linuxianer99/ga_fuelstation_terminal_hw/README.md

# GA_FuelStation_Terminal_HW

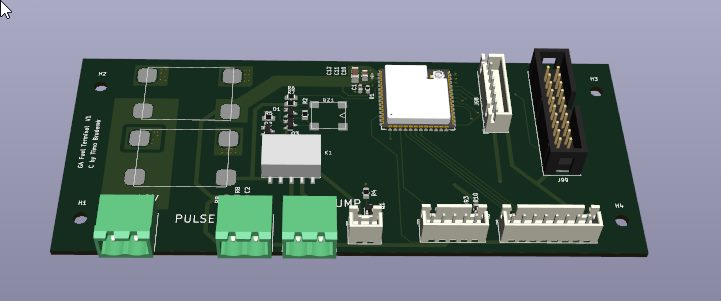
[picture p1: doc/PCB.jpg]
Picture of the PCB PCB


## Name
This is the hardware repository for GA GA_FuelStation_Terminal

## Description
KICAD Project for an RFID Terminal based on ESP32-S3
