linuxianer99/ga_fuelstation_terminal_hw/BOM.ods

Source: | E:\code_temp\GA Fuel Station\GA_FuelStation_Terminal\hardware\GA_Fuelstation_Terminal\GA_Fuelstation_Terminal.kicad_sch
Date: | 18.06.2023 13:51:07
Tool: | Eeschema 7.0.2
Generator: | D:\Program Files\KiCad\7.0\bin\scripting\plugins/bom_csv_grouped_by_value_with_fp.py
Component Count: | 34
Ref | Qnty | Value | Cmp name | Footprint | Description
BZ1 | 1 | Buzzer | Buzzer | GA_Fuelstation_Terminal:8530-SMD | Buzzer, polarized
C1 | 1 | 1u | C | Capacitor_SMD:C_0603_1608Metric_Pad1.08x0.95mm_HandSolder | Unpolarized capacitor
C2 | 1 | 100nF | C | Capacitor_SMD:C_0603_1608Metric_Pad1.08x0.95mm_HandSolder | Unpolarized capacitor
C10 | 1 | 100nF / 50V | C | Capacitor_SMD:C_0402_1005Metric_Pad0.74x0.62mm_HandSolder | Unpolarized capacitor
C11 | 1 | 1uF | C | Capacitor_SMD:C_0805_2012Metric_Pad1.18x1.45mm_HandSolder | Unpolarized capacitor
C12 | 1 | 10uF / 25V | C | Capacitor_SMD:C_1206_3216Metric_Pad1.33x1.80mm_HandSolder | Unpolarized capacitor
D1 | 1 | D | D | Package_TO_SOT_SMD:SOT-23 | Diode
H1, H2, H3, H4 | 4 | MountingHole | MountingHole | MountingHole:MountingHole_3.2mm_M3 | Mounting Hole without connection
IC1 | 1 | ESP32-S3-WROOM-1 | ESP32-S3-WROOM-1 | Espressif:ESP32-S3-WROOM-1U | 2.4 GHz WiFi (802.11 b/g/n) and Bluetooth Â® 5 (LE) module Built around ESP32S3 series of SoCs, Xtensa Â® dualcore 32bit LX7 microprocessor Flash up to 16 MB, PSRAM up to 8 MB 36 GPIOs, rich set of peripherals Onboard PCB antenna
J1 | 1 | Conn_01x08_Pin | Conn_01x08_Pin | Connector_JST:JST_XH_B8B-XH-AM_1x08_P2.50mm_Vertical | Generic connector, single row, 01x08, script generated
J2 | 1 | Conn_01x05_Pin | Conn_01x05_Pin | Connector_JST:JST_XH_B5B-XH-AM_1x05_P2.50mm_Vertical | Generic connector, single row, 01x05, script generated
J5 | 1 | Conn_01x02_Pin | Conn_01x02_Pin | Connector_JST:JST_XH_B2B-XH-AM_1x02_P2.50mm_Vertical | Generic connector, single row, 01x02, script generated
J6, J7, J10 | 3 | Screw_Terminal_01x02 | Screw_Terminal_01x02 | Connector_Phoenix_MSTB:PhoenixContact_MSTBA_2,5_2-G-5,08_1x02_P5.08mm_Horizontal | Generic screw terminal, single row, 01x02, script generated (kicad-library-utils/schlib/autogen/connector/)
J98 | 1 | Conn_01x07_Socket | Conn_01x07_Socket | Connector_JST:JST_XH_B7B-XH-AM_1x07_P2.50mm_Vertical | Generic connector, single row, 01x07, script generated
J99 | 1 | Conn_ARM_JTAG_SWD_20 | Conn_ARM_JTAG_SWD_20 | Connector_IDC:IDC-Header_2x10_P2.54mm_Vertical | Standard IDC20 Pinheader Connector, ARM legacy JTAG and SWD interface
K1 | 1 | ~ | TQ2SA | GA_Fuelstation_Terminal:TQ2SA
Q1, Q2, Q3 | 3 | 2N7002 | 2N7002 | Package_TO_SOT_SMD:SOT-23 | 0.115A Id, 60V Vds, N-Channel MOSFET, SOT-23
R1 | 1 | 10k | R | Resistor_SMD:R_0603_1608Metric_Pad0.98x0.95mm_HandSolder | Resistor
R2 | 1 | 1k | R | Resistor_SMD:R_0805_2012Metric_Pad1.20x1.40mm_HandSolder | Resistor
R4, R5, R6 | 3 | 100 | R | Resistor_SMD:R_0805_2012Metric_Pad1.20x1.40mm_HandSolder | Resistor
R7 | 1 | R | R | Resistor_SMD:R_0805_2012Metric_Pad1.20x1.40mm_HandSolder | Resistor
R8 | 1 | 12k | R | Resistor_SMD:R_0805_2012Metric_Pad1.20x1.40mm_HandSolder | Resistor
R9 | 1 | 50k | R | Resistor_SMD:R_0805_2012Metric_Pad1.20x1.40mm_HandSolder | Resistor
U1 | 1 | 3V3 | DCDC | GA_Fuelstation_Terminal:XLZMYQ
U2 | 1 | 5V | DCDC | GA_Fuelstation_Terminal:XLZMYQ
