linuxianer99/ga_fuelstation_terminal_hw/releases/V1/bom.csv

Designator | Footprint | Quantity | Value | LCSC Part #
BZ1 | 8530-SMD | 1 | Buzzer
C1 | 0603 | 1 | 1u
C10 | 0402 | 1 | 100nF / 50V
C11 | 0805 | 1 | 1uF
C12 | 1206 | 1 | 10uF / 25V
C2 | 0603 | 1 | 100nF
D1 | SOT-23 | 1 | D
H1, H2, H3, H4 | MountingHole_3.2mm_M3 | 4 | MountingHole
IC1 | ESP32-S3-WROOM-1U | 1 | ESP32-S3-WROOM-1
J1 | JST_XH_B8B-XH-AM_1x08_P2.50mm_Vertical | 1 | Conn_01x08_Pin
J10, J6, J7 | PhoenixContact_MSTBA_2,5_2-G-5,08_1x02_P5.08mm_Horizontal | 3 | Screw_Terminal_01x02
J2 | JST_XH_B5B-XH-AM_1x05_P2.50mm_Vertical | 1 | Conn_01x05_Pin
J5 | JST_XH_B2B-XH-AM_1x02_P2.50mm_Vertical | 1 | Conn_01x02_Pin
J98 | JST_XH_B7B-XH-AM_1x07_P2.50mm_Vertical | 1 | Conn_01x07_Socket
J99 | IDC-Header_2x10_P2.54mm_Vertical | 1 | Conn_ARM_JTAG_SWD_20
K1 | TQ2SA | 1 | ~
Q1, Q2, Q3 | SOT-23 | 3 | 2N7002
R1 | 0603 | 1 | 10k
R10, R3 | 0805 | 2 | 0R
R2 | 0805 | 1 | 1k
R4, R5, R6 | 0805 | 3 | 100
R7 | 0805 | 1 | R
R8 | 0805 | 1 | 12k
R9 | 0805 | 1 | 50k
U1 | XLZMYQ | 1 | 3V3
U2 | XLZMYQ | 1 | 5V
