linuxianer99/ga_fuelstation_terminal_hw/3D/WIZ850IO--3DModel-STEP-269445.STEP

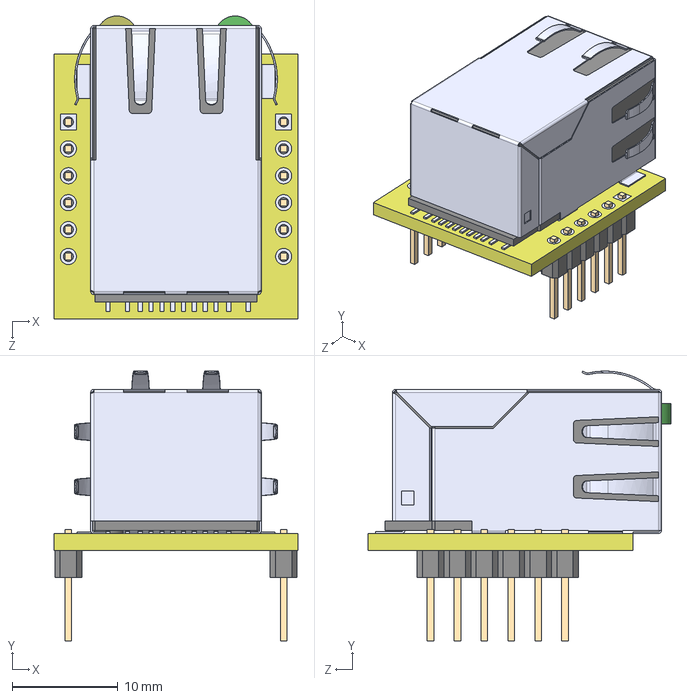
[picture p2: CAD file, 2026-10-18]
3D/WIZ850IO--3DModel-STEP-269445.STEP
23.0 x 25.5 x 28.6 mm
