linuxianer99/ga_fuelstation_terminal_hw/GA_Fuelstation_Terminal.step

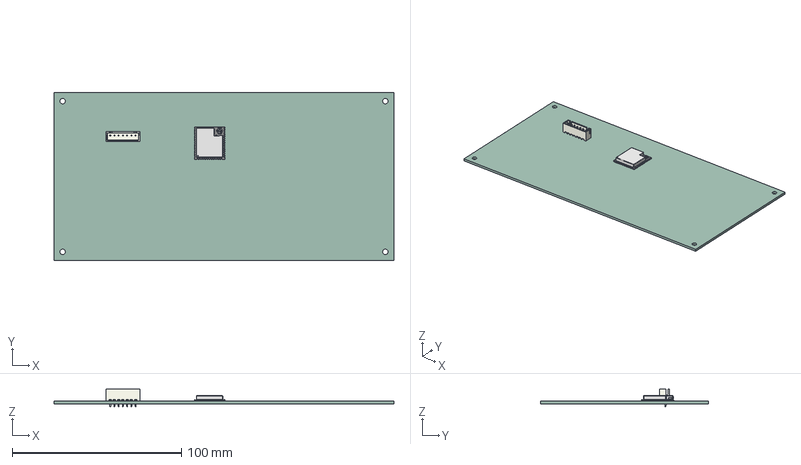
[picture p3: CAD file, 2023-06-21]
GA_Fuelstation_Terminal.step
200.7 x 99.1 x 10.4 mm
GA_Fuelstation_Terminal PCB
