linuxianer99/ga_fuelstation_terminal_hw/GA_Fuelstation_Terminal.pdf

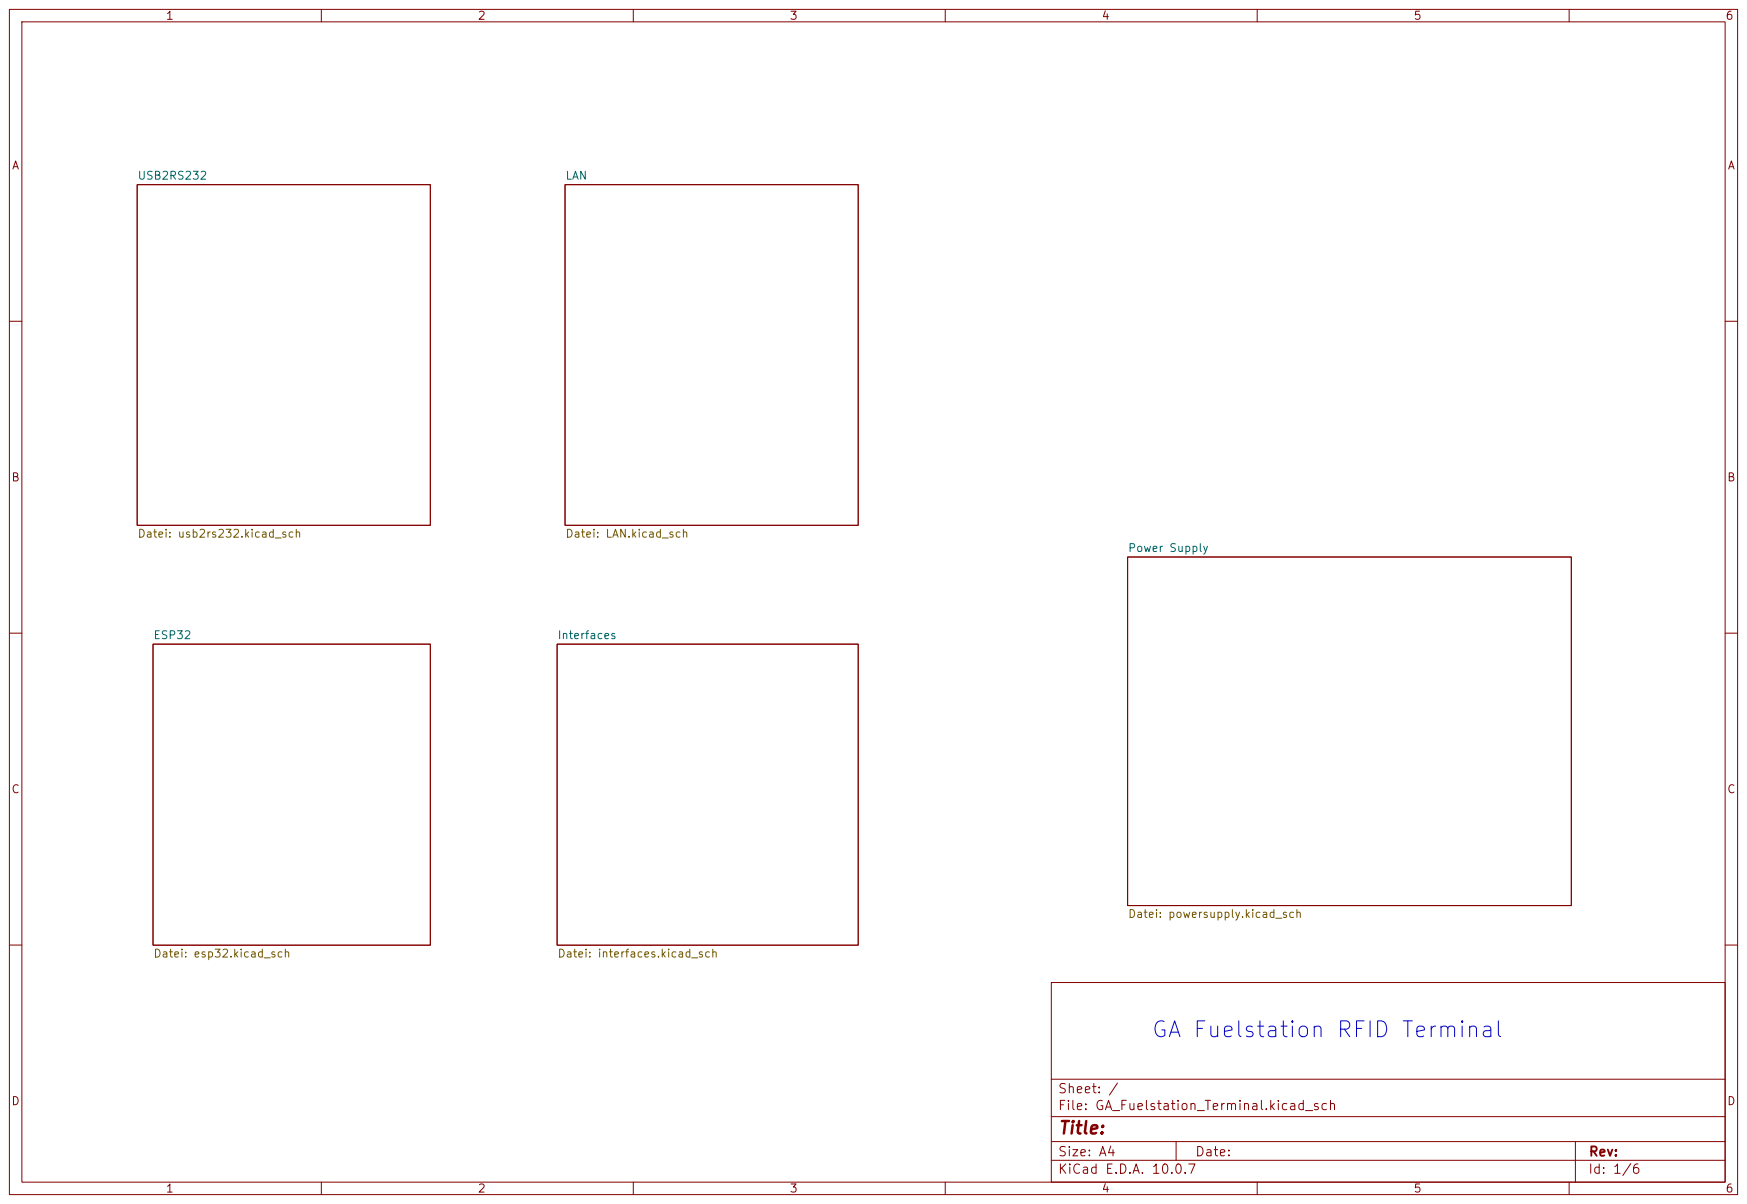
[picture p4: page 1]

Size: A4 | Rev:
KiCad E.D.A. 10.0.7 | Id: 1/6

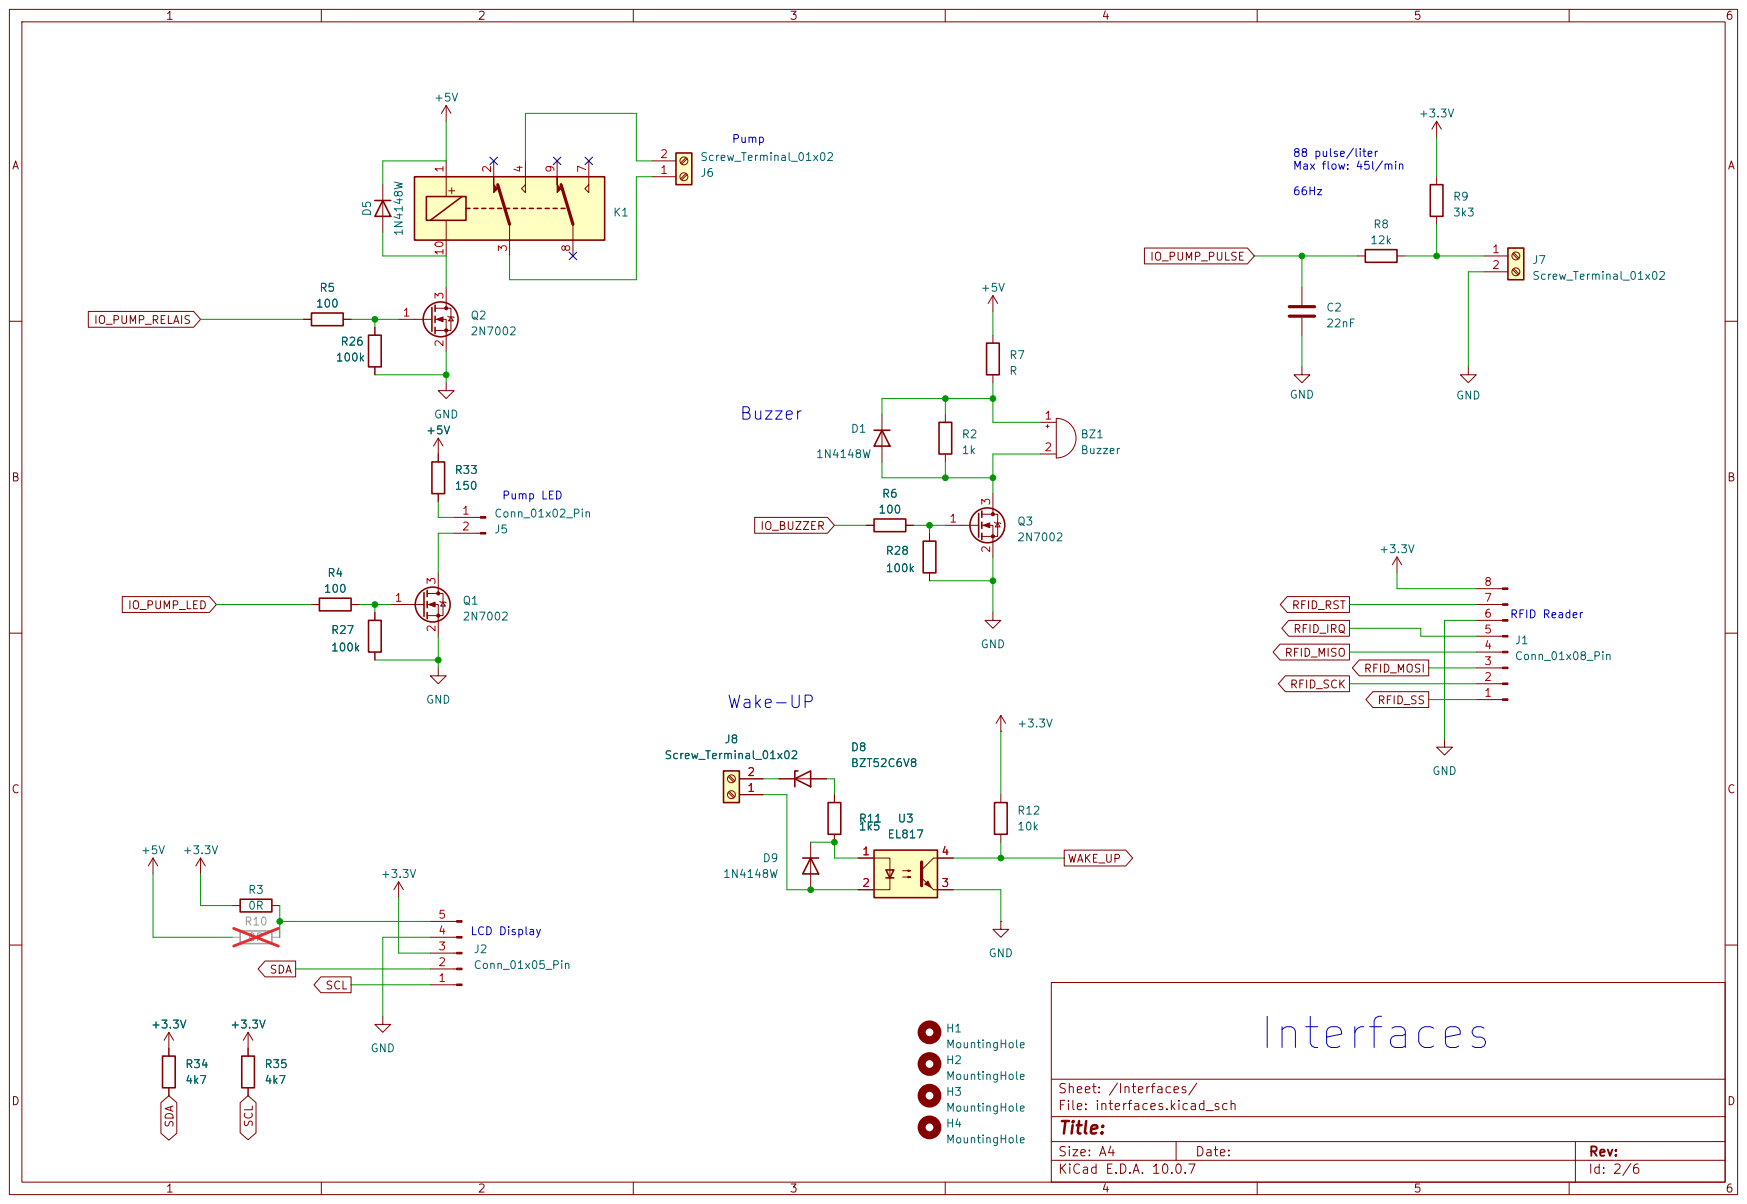
[picture p5: page 2]

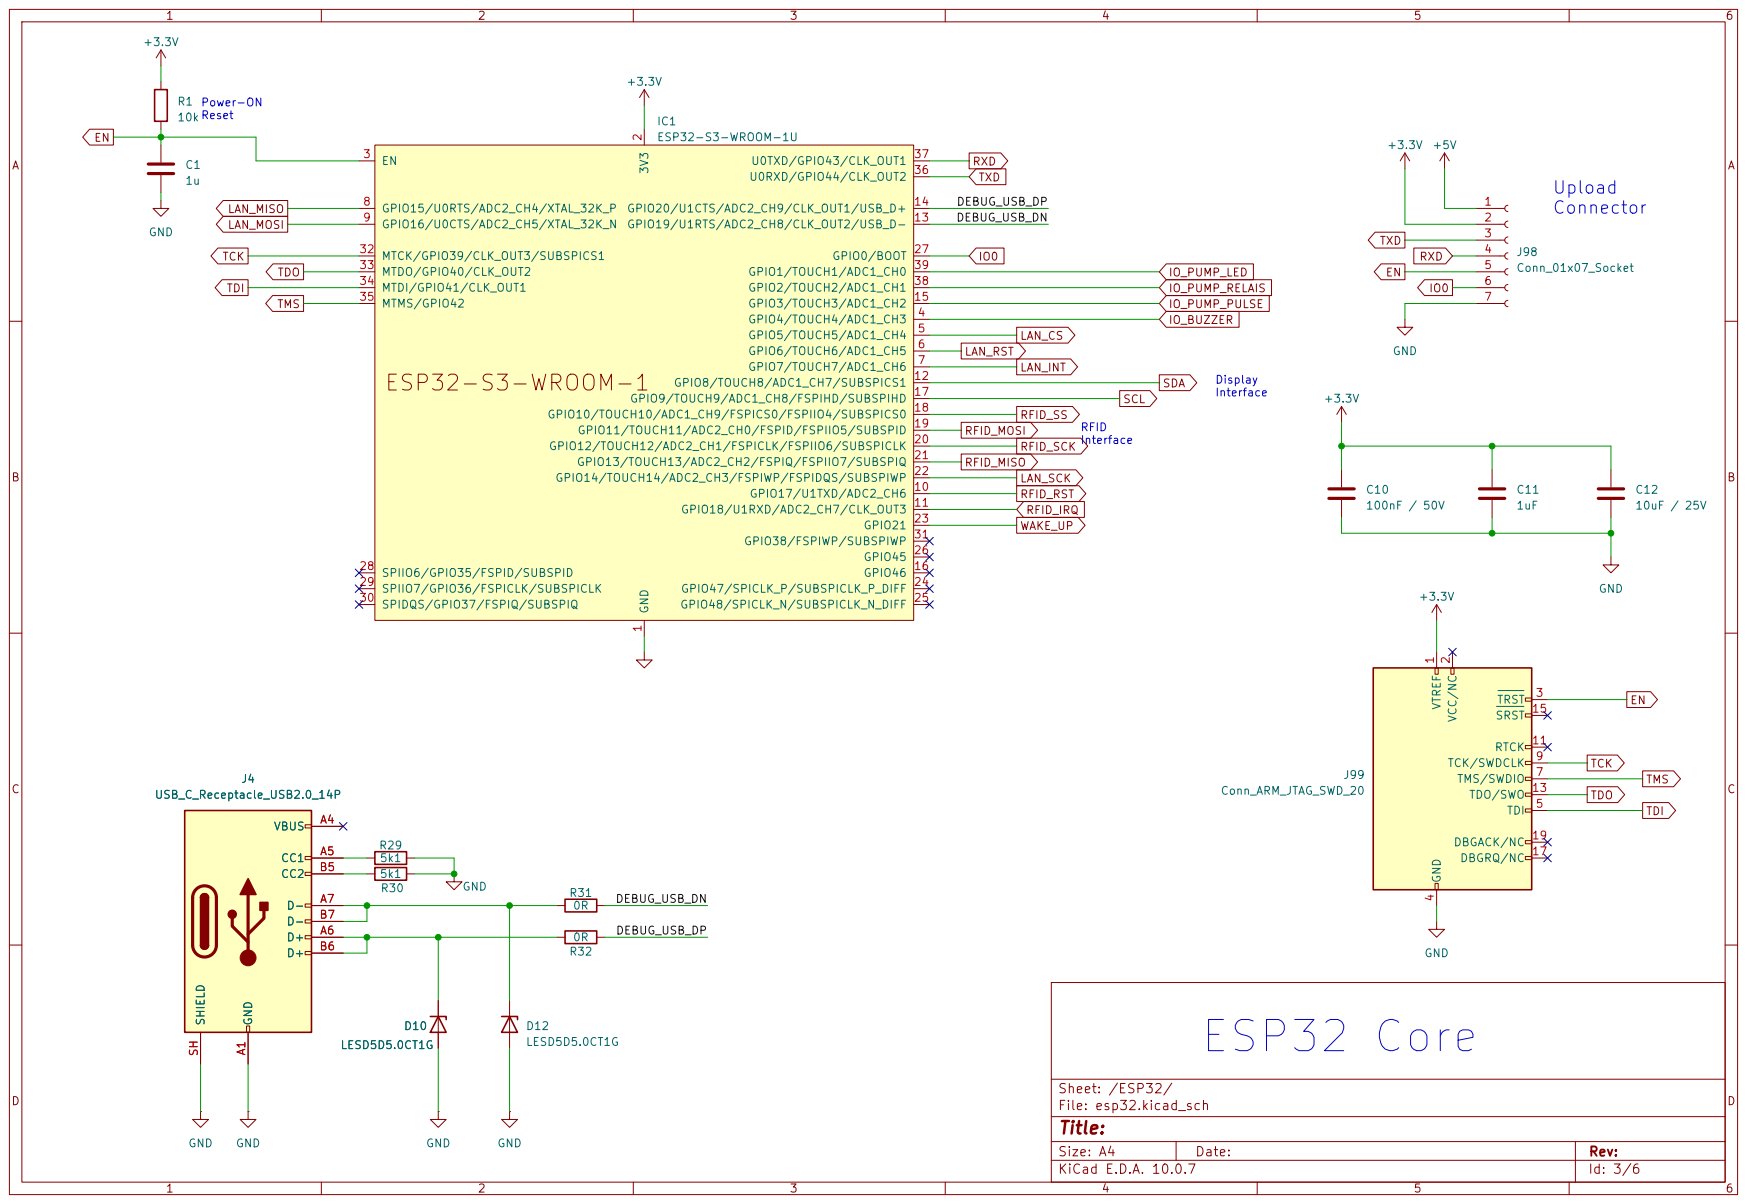
[picture p6: page 3]

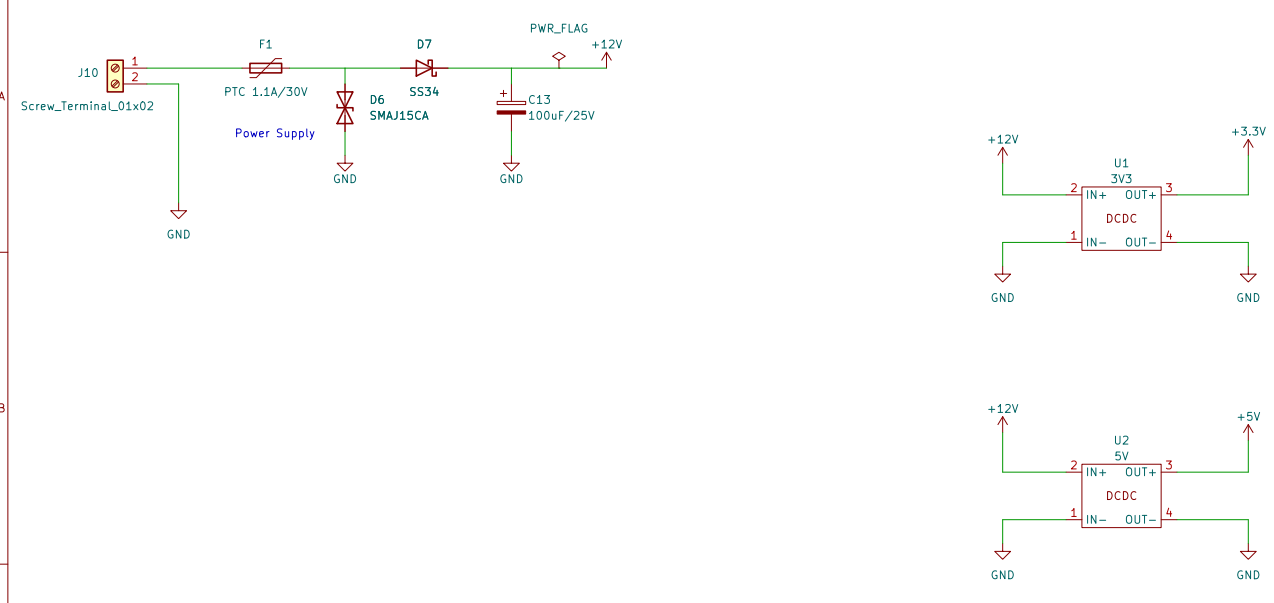
[picture p7: page 4]

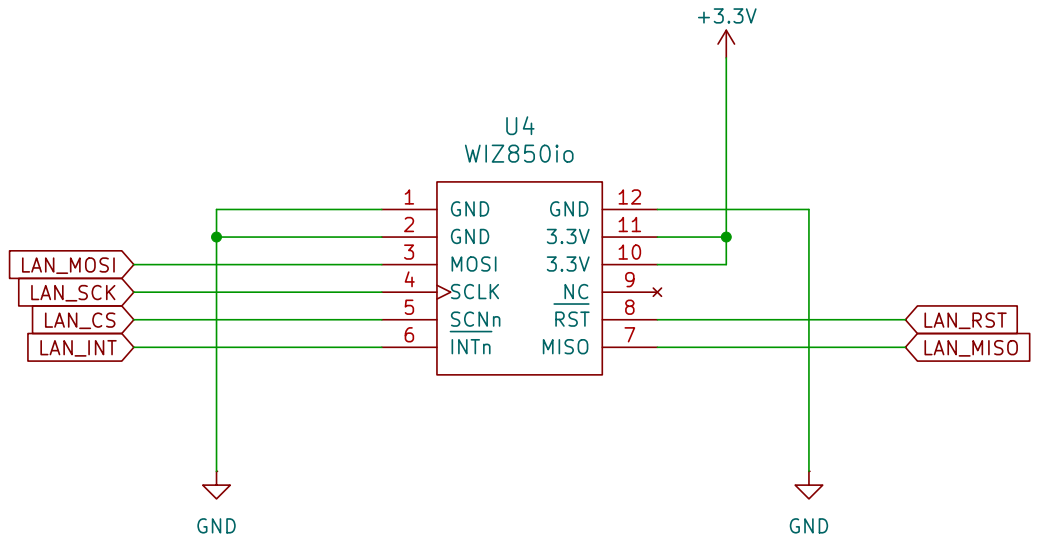
[picture p8: page 5]

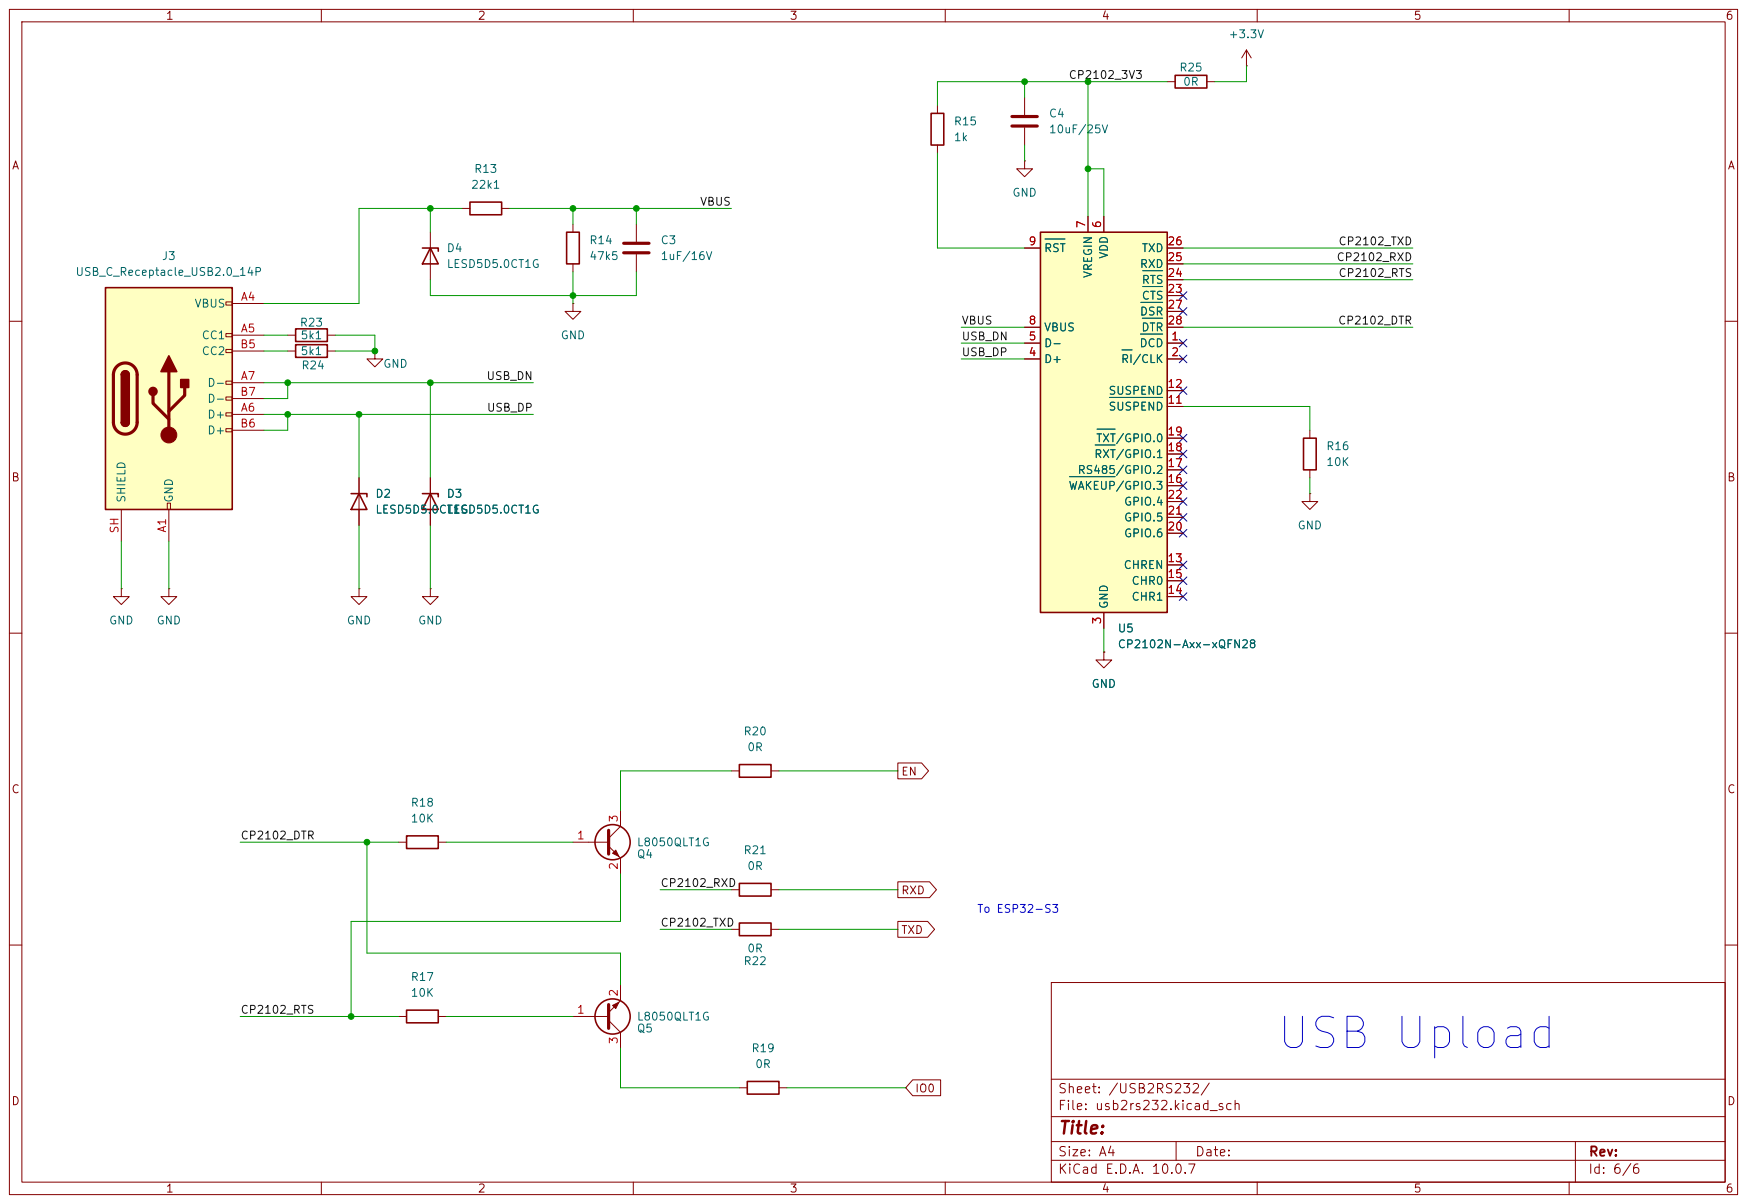
[picture p9: page 6]

SUSPEND 11 SUSPEND 12 CHREN 13 CHR1 14 CHR0 15 WAKEUP/GPIO.3 16 RS485/GPIO.2 17 RXT/GPIO.1 18 TXT/GPIO.0 19 GPIO.6 20 GPIO.5 21 GPIO.4 22 CTS 23 RTS 24 RXD 25 TXD 26 DSR 27 DTR 28

SUSPEND 11 SUSPEND 12 CHREN 13 CHR1 14 CHR0 15 WAKEUP/GPIO.3 16 RS485/GPIO.2 17 RXT/GPIO.1 18 TXT/GPIO.0 19 GPIO.6 20 GPIO.5 21 GPIO.4 22 CTS 23 RTS 24 RXD 25 TXD 26 DSR 27 DTR 28 U5CP2102N-Axx-xQFN28 GND
