linuxianer99/ga_fuelstation_terminal_hw/GA_Fuelstation_Terminal.kicad_pcb

## KiCad design GA_Fuelstation_Terminal.kicad_pcb (2026-11-08)

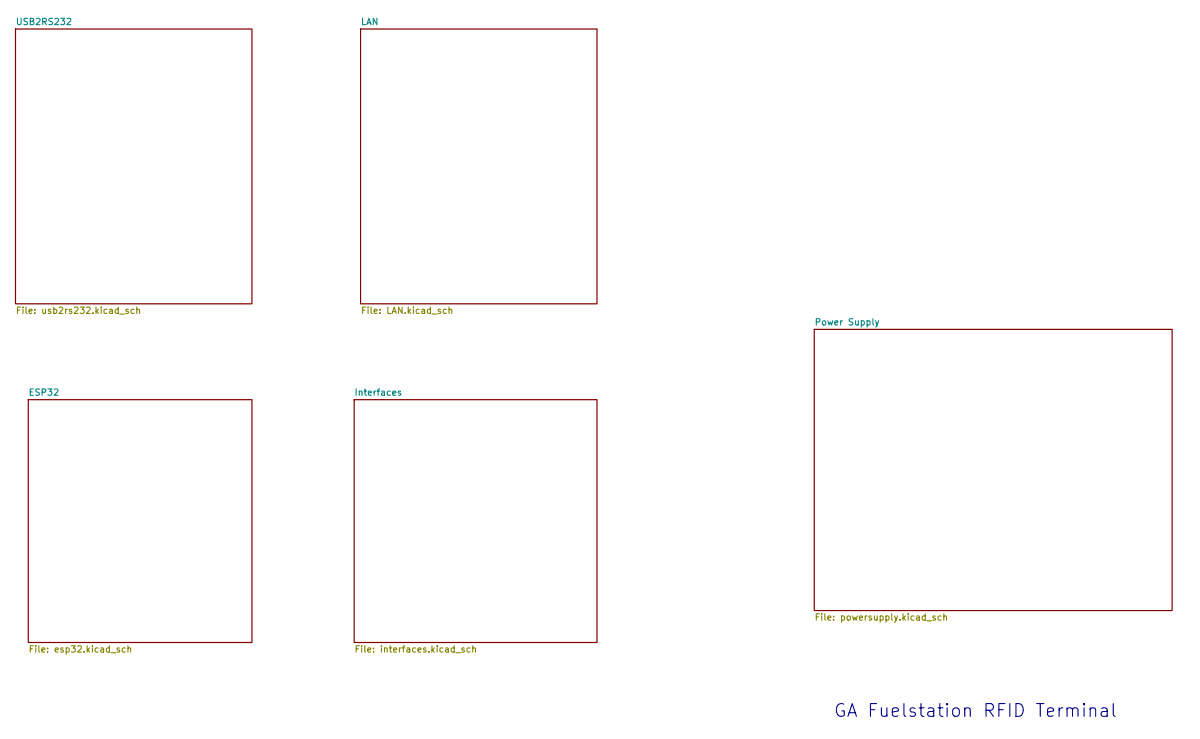
[picture p14: schematic GA_Fuelstation_Terminal.kicad_sch]

Notes on the sheet:
GA Fuelstation RFID Terminal

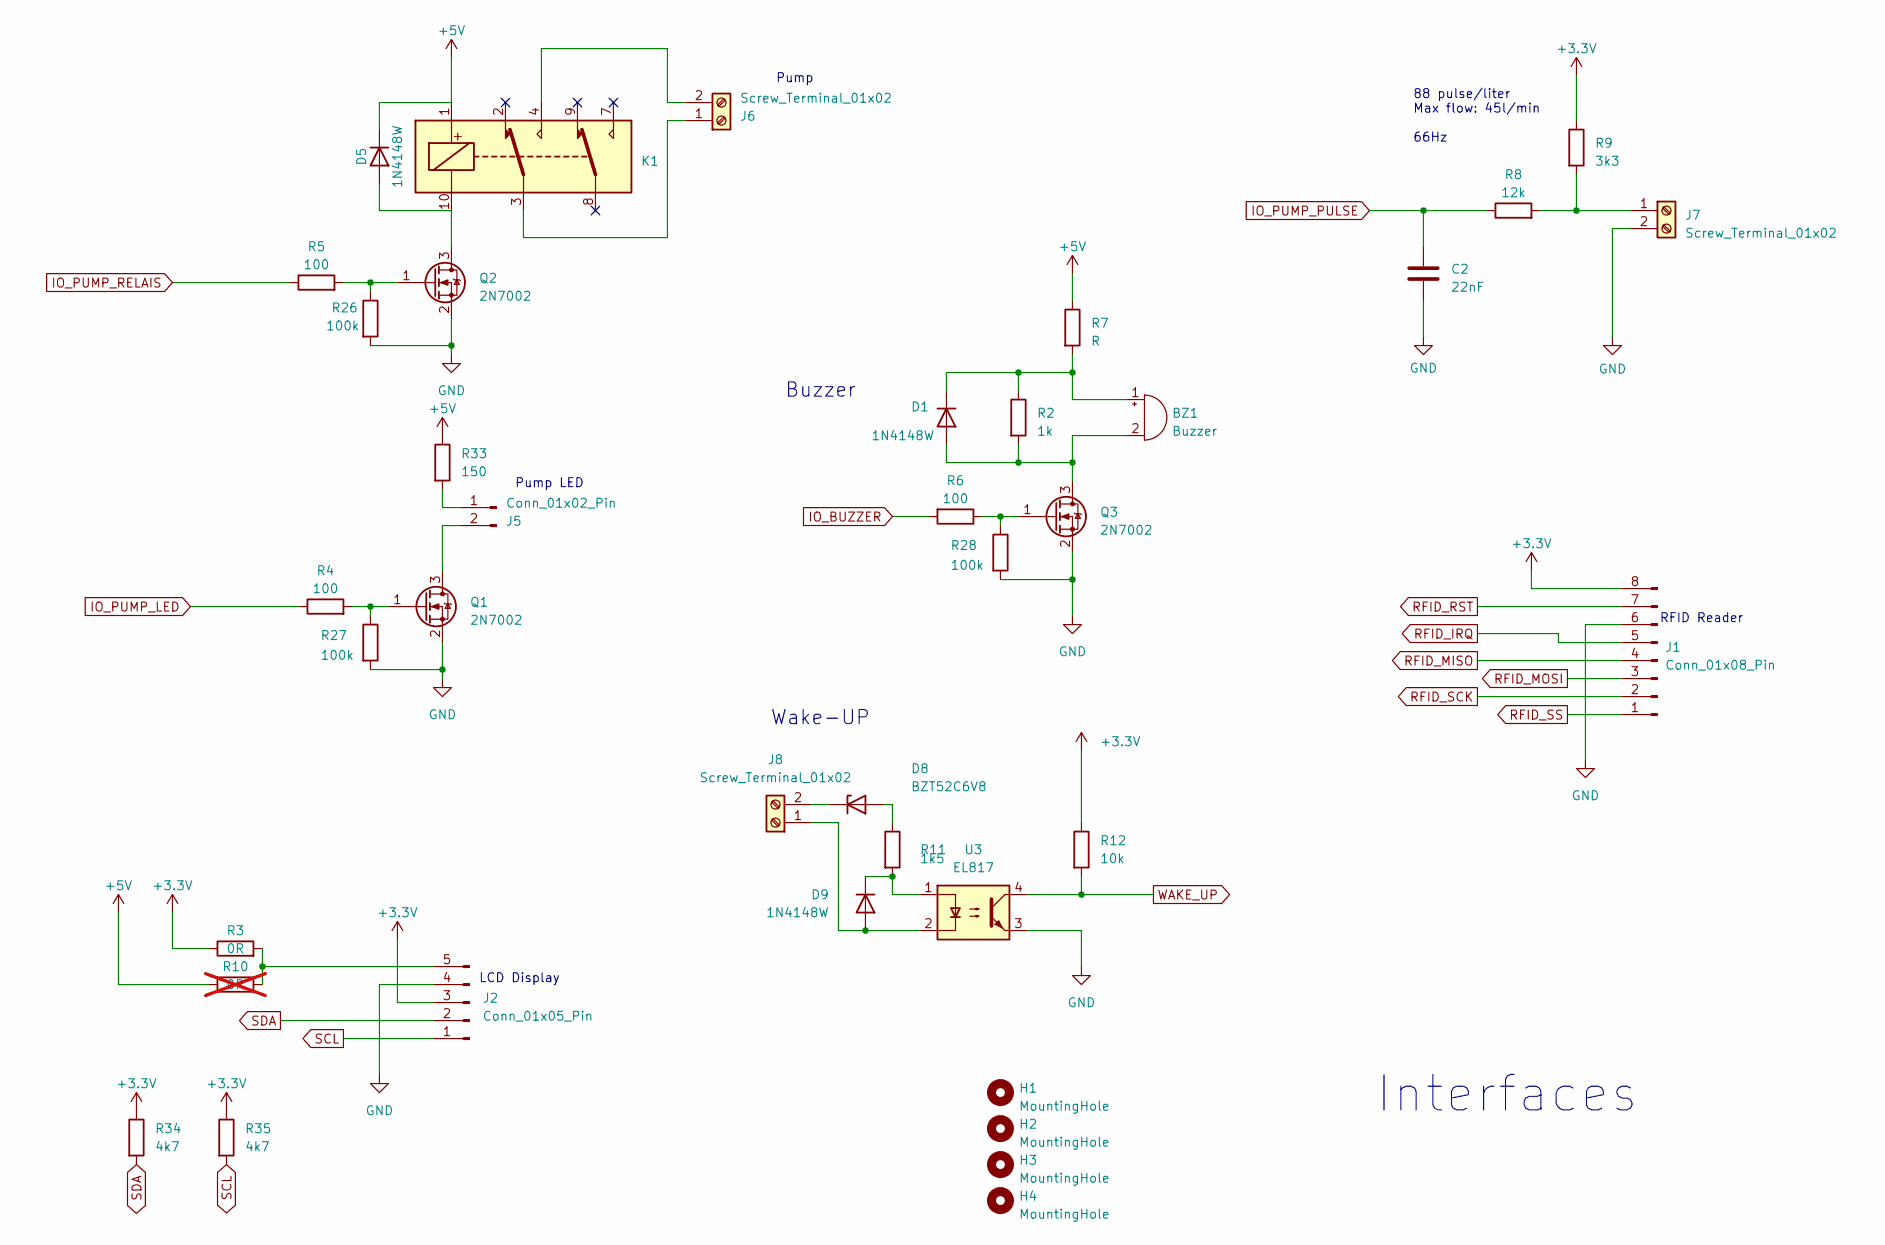
[picture p15: schematic interfaces.kicad_sch]

Parts:
BZ1: Buzzer; 8530-SMD
C2: 22nF; C_0603_1608Metric_Pad1.08x0.95mm_HandSolder
D1, D5, D9: 1N4148W; D_SOD-123; LCSC C81598
D8: BZT52C6V8; D_SOD-123; LCSC C173404
H1, H2, H3, H4: MountingHole; MountingHole_3.2mm_M3
J1: Conn_01x08_Pin; JST_XH_B8B-XH-AM_1x08_P2.50mm_Vertical
J2: Conn_01x05_Pin; JST_XH_B5B-XH-AM_1x05_P2.50mm_Vertical
J5: Conn_01x02_Pin; JST_XH_B2B-XH-AM_1x02_P2.50mm_Vertical
J6, J7, J8: Screw_Terminal_01x02; PhoenixContact_MSTBA_2,5_2-G-5,08_1x02_P5.08mm_Horizontal
K1: TQ2SA
Q1, Q2, Q3: 2N7002; SOT-23
R2: 1k; R_0805_2012Metric_Pad1.20x1.40mm_HandSolder
R3: 0R; R_0805_2012Metric_Pad1.20x1.40mm_HandSolder
R4, R5, R6: 100; R_0805_2012Metric_Pad1.20x1.40mm_HandSolder
R7: R; R_0805_2012Metric_Pad1.20x1.40mm_HandSolder
R8: 12k; R_0805_2012Metric_Pad1.20x1.40mm_HandSolder
R9: 3k3; R_0805_2012Metric_Pad1.20x1.40mm_HandSolder
R10: 0R; R_0805_2012Metric_Pad1.20x1.40mm_HandSolder; not fitted
R11: 1k5; R_0805_2012Metric_Pad1.20x1.40mm_HandSolder; LCSC C4310
R12: 10k; R_0603_1608Metric_Pad0.98x0.95mm_HandSolder
R26, R27, R28: 100k; R_0402_1005Metric_Pad0.72x0.64mm_HandSolder
R33: 150; R_0805_2012Metric_Pad1.20x1.40mm_HandSolder
R34, R35: 4k7; R_0805_2012Metric_Pad1.20x1.40mm_HandSolder
U3: EL817; SMDIP-4_W9.53mm; LCSC C63268

Connections:
+3.3V: J1.8, J2.3, R3.1, R9.1, R12.1, R34.1, R35.1; also elsewhere on the board
+5V: D5.1 (K), K1.1, R7.1, R10.1, R33.1; also elsewhere on the board
GND: C2.2, J1.6, J2.4, J7.2, Q1.2 (S), Q2.2 (S), Q3.2 (S), R26.2, R27.2, R28.2, U3.3; also elsewhere on the board
IO_BUZZER: R6.2; also elsewhere on the board
IO_PUMP_LED: R4.1; also elsewhere on the board
IO_PUMP_PULSE: C2.1, R8.1; also elsewhere on the board
IO_PUMP_RELAIS: R5.1; also elsewhere on the board
unnamed: BZ1.2 (+), D1.2 (A), Q3.3 (D), R2.2
unnamed: BZ1.1 (-), D1.1 (K), R2.1, R7.2
unnamed: D5.2 (A), K1.10, Q2.3 (D)
unnamed: D8.2 (A), R11.1
unnamed: D8.1 (K), J8.2
unnamed: D9.2 (A), J8.1, U3.2
unnamed: D9.1 (K), R11.2, U3.1
unnamed: J2.5, R3.2, R10.2
unnamed: J5.1, R33.2
unnamed: J5.2, Q1.3 (D)
unnamed: J6.1, K1.3
unnamed: J6.2, K1.4
unnamed: J7.1, R8.2, R9.2
unnamed: Q1.1 (G), R4.2, R27.1
unnamed: Q2.1 (G), R5.2, R26.1
unnamed: Q3.1 (G), R6.1, R28.1
RFID_IRQ: J1.5; also elsewhere on the board
RFID_MISO: J1.4; also elsewhere on the board
RFID_MOSI: J1.3; also elsewhere on the board
RFID_RST: J1.7; also elsewhere on the board
RFID_SCK: J1.2; also elsewhere on the board
RFID_SS: J1.1; also elsewhere on the board
SCL: J2.1, R35.2; also elsewhere on the board
SDA: J2.2, R34.2; also elsewhere on the board
WAKE_UP: R12.2, U3.4; also elsewhere on the board

Notes on the sheet:
Buzzer
RFID Reader
Pump
88 pulse/liter Max flow: 45l/min 66Hz
Wake-UP
LCD Display
Pump LED
Interfaces

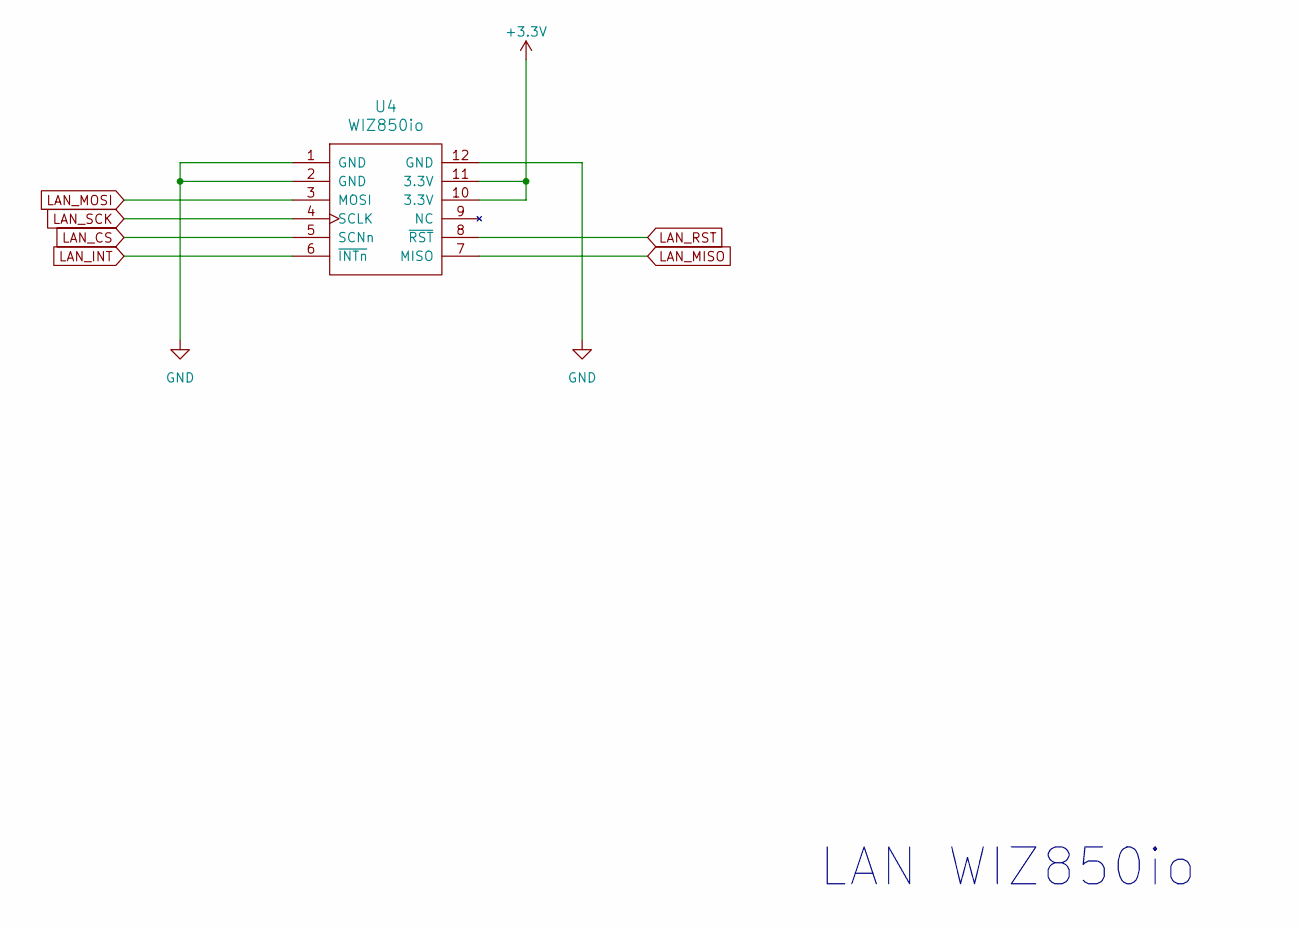
[picture p16: schematic LAN.kicad_sch]

Parts:
U4: WIZ850io

Connections:
+3.3V: U4.10 (3.3V), U4.11 (3.3V); also elsewhere on the board
GND: U4.1 (GND), U4.2 (GND), U4.12 (GND); also elsewhere on the board
LAN_CS: U4.5 (SCNn); also elsewhere on the board
LAN_INT: U4.6 (~INTn); also elsewhere on the board
LAN_MISO: U4.7 (MISO); also elsewhere on the board
LAN_MOSI: U4.3 (MOSI); also elsewhere on the board
LAN_RST: U4.8 (~RST); also elsewhere on the board
LAN_SCK: U4.4 (SCLK); also elsewhere on the board

Notes on the sheet:
LAN WIZ850io

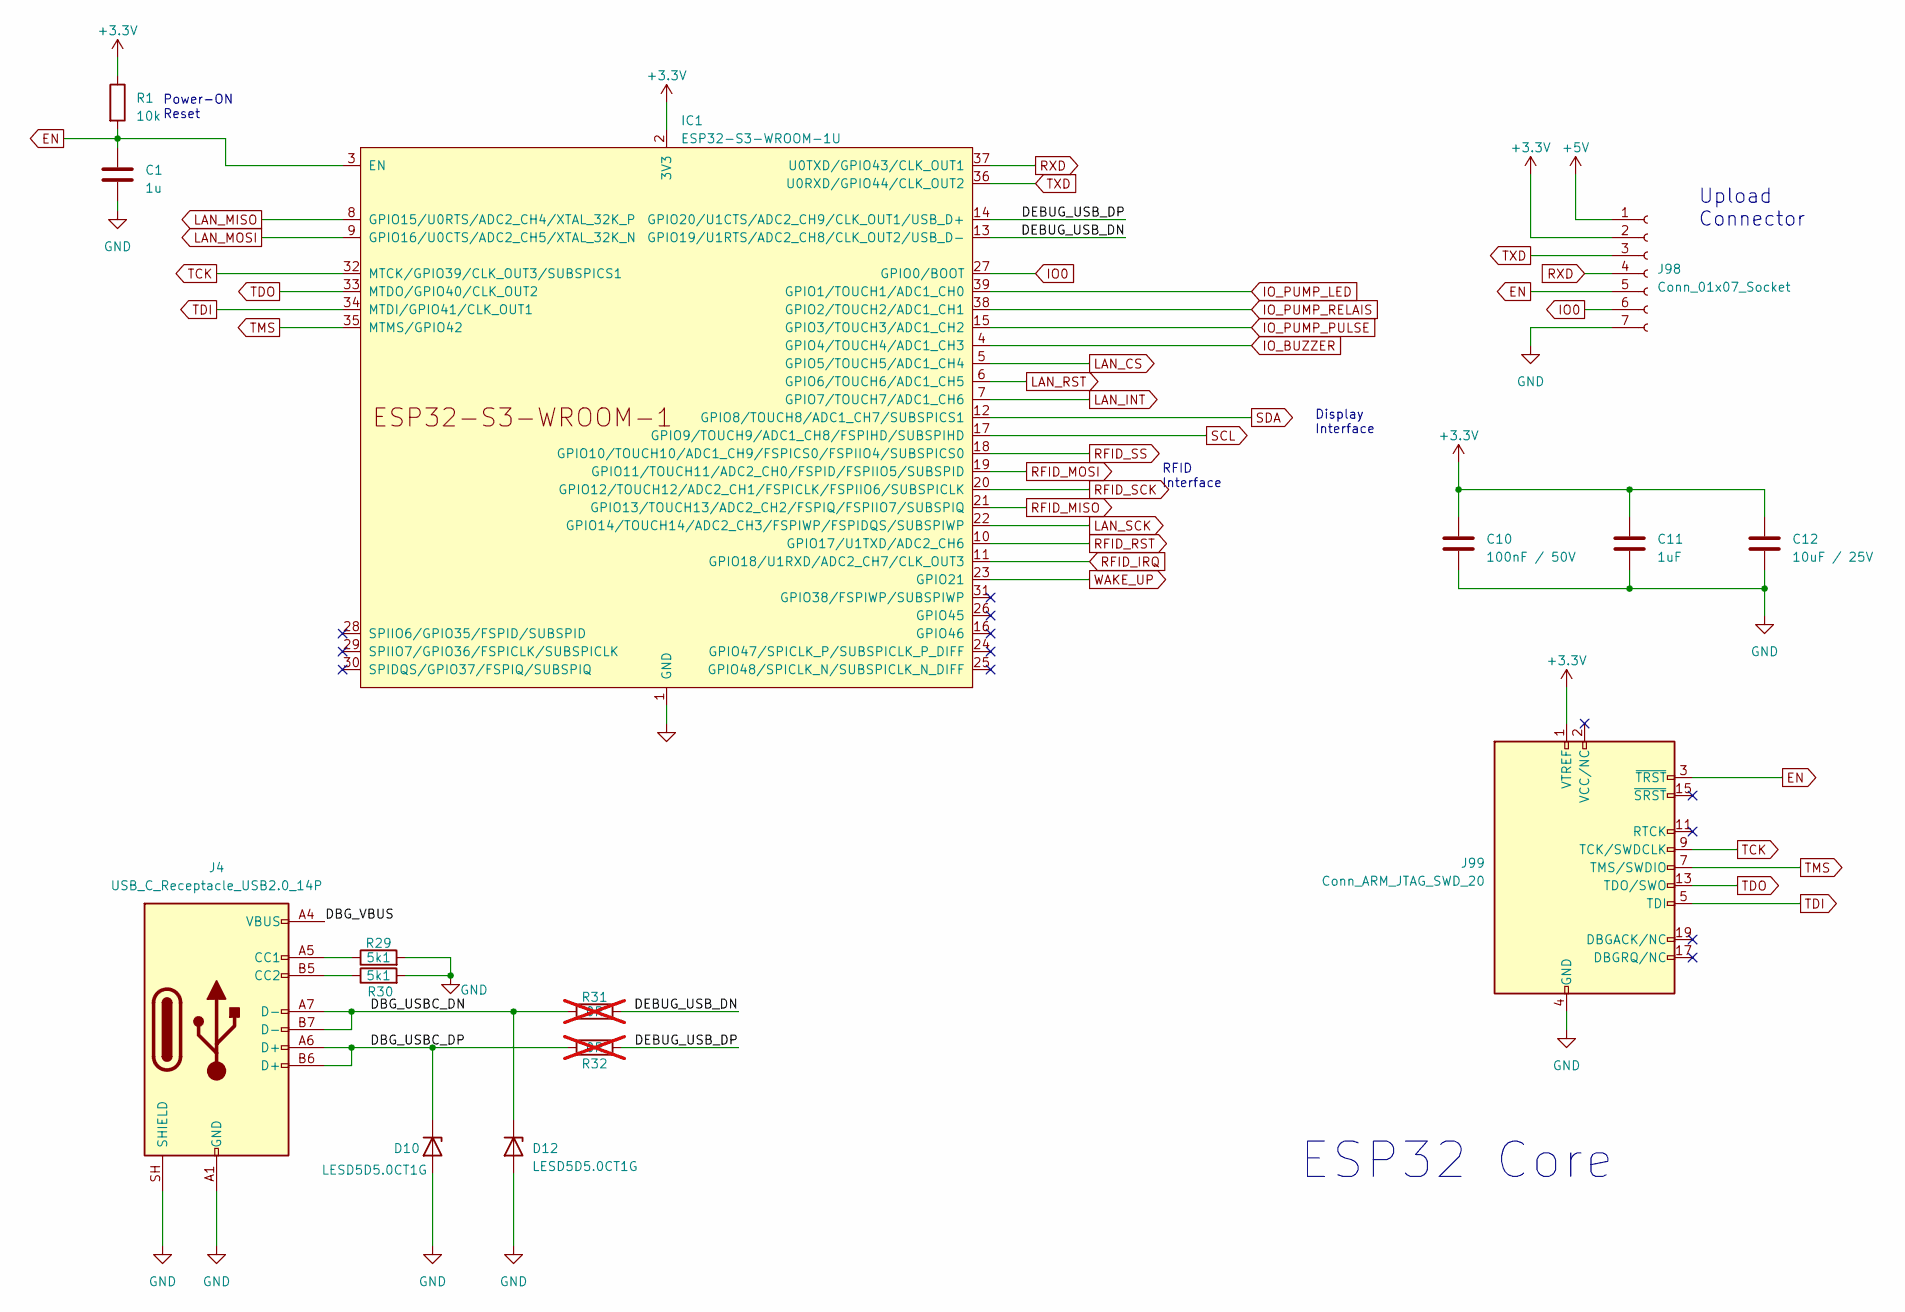
[picture p17: schematic esp32.kicad_sch]

Parts:
C1: 1u; C_0603_1608Metric_Pad1.08x0.95mm_HandSolder
C10: 100nF / 50V; C_0402_1005Metric_Pad0.74x0.62mm_HandSolder
C11: 1uF; C_0805_2012Metric_Pad1.18x1.45mm_HandSolder
C12: 10uF / 25V; C_1206_3216Metric_Pad1.33x1.80mm_HandSolder
D10, D12: LESD5D5.0CT1G; D_SOD-523
IC1: ESP32-S3-WROOM-1U
J4: USB_C_Receptacle_USB2.0_14P; USB_C_Receptacle_HRO_TYPE-C-31-M-12
J98: Conn_01x07_Socket; JST_XH_B7B-XH-AM_1x07_P2.50mm_Vertical
J99: Conn_ARM_JTAG_SWD_20; IDC-Header_2x10_P2.54mm_Vertical
R1: 10k; R_0603_1608Metric_Pad0.98x0.95mm_HandSolder
R29, R30: 5k1; R_0603_1608Metric_Pad0.98x0.95mm_HandSolder
R31, R32: 0R; R_0402_1005Metric; LCSC C17168; not fitted

Connections:
+3.3V: C10.1, C11.1, C12.1, IC1.2 (3V3), J98.2, J99.1 (VTREF), R1.1; also elsewhere on the board
+5V: J98.1; also elsewhere on the board
/ESP32/DBG_USBC_DN: D12.1 (K), J4.A7 (D-), J4.B7 (D-), R31.1
/ESP32/DBG_USBC_DP: D10.1 (K), J4.A6 (D+), J4.B6 (D+), R32.1
/ESP32/DBG_VBUS: J4.A4 (VBUS), J4.A9 (VBUS), J4.B4 (VBUS), J4.B9 (VBUS)
/ESP32/DEBUG_USB_DN: IC1.13 (GPIO19/U1RTS/ADC2_CH8/CLK_OUT2/USB_D-), R31.2
/ESP32/DEBUG_USB_DP: IC1.14 (GPIO20/U1CTS/ADC2_CH9/CLK_OUT1/USB_D+), R32.2
EN: C1.1, IC1.3 (EN), J98.5, J99.3 (~TRST), R1.2; also elsewhere on the board
GND: C1.2, C10.2, C11.2, C12.2, D10.2 (A), D12.2 (A), IC1.1 (GND), IC1.40 (GND), IC1.41 (GND), J4.A1 (GND), J4.A12 (GND), J4.B1 (GND), J4.B12 (GND), J4.SH (SHIELD), J98.7, J99.4 (GND), J99.6 (GND), J99.8 (GND), J99.10 (GND), J99.12 (GND), J99.14 (GND), J99.16 (GND), J99.18 (GND), J99.20 (GND), R29.2, R30.2; also elsewhere on the board
IO0: IC1.27 (GPIO0/BOOT), J98.6; also elsewhere on the board
IO_BUZZER: IC1.4 (GPIO4/TOUCH4/ADC1_CH3); also elsewhere on the board
IO_PUMP_LED: IC1.39 (GPIO1/TOUCH1/ADC1_CH0); also elsewhere on the board
IO_PUMP_PULSE: IC1.15 (GPIO3/TOUCH3/ADC1_CH2); also elsewhere on the board
IO_PUMP_RELAIS: IC1.38 (GPIO2/TOUCH2/ADC1_CH1); also elsewhere on the board
LAN_CS: IC1.5 (GPIO5/TOUCH5/ADC1_CH4); also elsewhere on the board
LAN_INT: IC1.7 (GPIO7/TOUCH7/ADC1_CH6); also elsewhere on the board
LAN_MISO: IC1.8 (GPIO15/U0RTS/ADC2_CH4/XTAL_32K_P); also elsewhere on the board
LAN_MOSI: IC1.9 (GPIO16/U0CTS/ADC2_CH5/XTAL_32K_N); also elsewhere on the board
LAN_RST: IC1.6 (GPIO6/TOUCH6/ADC1_CH5); also elsewhere on the board
LAN_SCK: IC1.22 (GPIO14/TOUCH14/ADC2_CH3/FSPIWP/FSPIDQS/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); also elsewhere on the board
unnamed: J4.A5 (CC1), R29.1
unnamed: J4.B5 (CC2), R30.1
RFID_IRQ: IC1.11 (GPIO18/U1RXD/ADC2_CH7/CLK_OUT3); also elsewhere on the board
RFID_MISO: IC1.21 (GPIO13/TOUCH13/ADC2_CH2/FSPIQ/FSPIIO7/S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); also elsewhere on the board
RFID_MOSI: IC1.19 (GPIO11/TOUCH11/ADC2_CH0/FSPID/FSPIIO5/S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); also elsewhere on the board
RFID_RST: IC1.10 (GPIO17/U1TXD/ADC2_CH6); also elsewhere on the board
RFID_SCK: IC1.20 (GPIO12/TOUCH12/ADC2_CH1/FSPICLK/FSPIIO6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); also elsewhere on the board
RFID_SS: IC1.18 (GPIO10/TOUCH10/ADC1_CH9/FSPICS0/FSPIIO4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); also elsewhere on the board
RXD: IC1.37 (U0TXD/GPIO43/CLK_OUT1), J98.4; also elsewhere on the board
SCL: IC1.17 (GPIO9/TOUCH9/ADC1_CH8/FSPIHD/SUBSPIHD); also elsewhere on the board
SDA: IC1.12 (GPIO8/TOUCH8/ADC1_CH7/SUBSPICS1); also elsewhere on the board
TCK: IC1.32 (MTCK/GPIO39/CLK_OUT3/SUBSPICS1), J99.9 (TCK/SWDCLK)
TDI: IC1.34 (MTDI/GPIO41/CLK_OUT1), J99.5 (TDI)
TDO: IC1.33 (MTDO/GPIO40/CLK_OUT2), J99.13 (TDO/SWO)
TMS: IC1.35 (MTMS/GPIO42), J99.7 (TMS/SWDIO)
TXD: IC1.36 (U0RXD/GPIO44/CLK_OUT2), J98.3; also elsewhere on the board
WAKE_UP: IC1.23 (GPIO21); also elsewhere on the board

Notes on the sheet:
Upload Connector
ESP32 Core
Display Interface
RFID Interface
Power-ON Reset

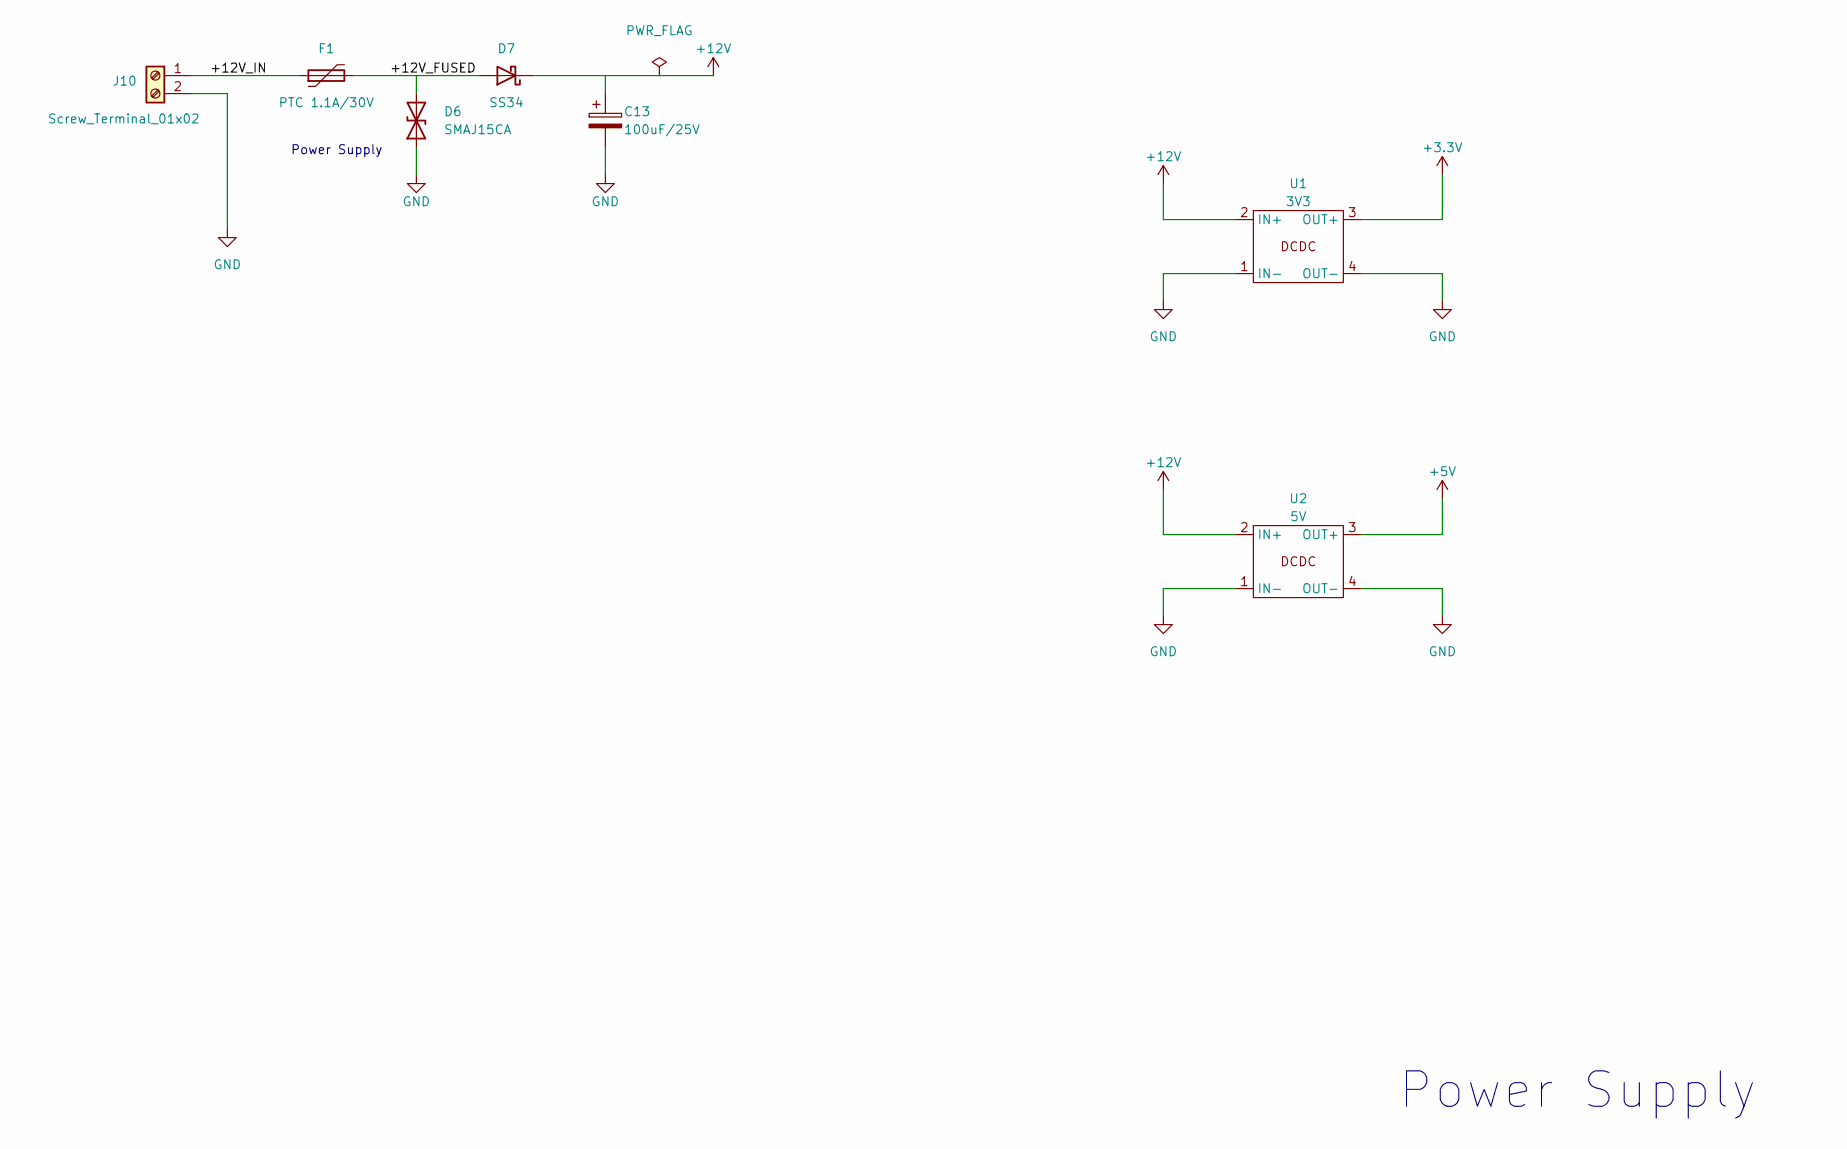
[picture p18: schematic powersupply.kicad_sch]

Parts:
C13: 100uF/25V; CP_Elec_6.3x7.7; LCSC C179802
D6: SMAJ15CA; D_SMA; LCSC C151939
D7: SS34; D_SMA; LCSC C8678
F1: PTC 1.1A/30V; Fuse_1812_4532Metric; LCSC C70119
J10: Screw_Terminal_01x02; PhoenixContact_MSTBA_2,5_2-G-5,08_1x02_P5.08mm_Horizontal
U1: 3V3; XLZMYQ
U2: 5V; XLZMYQ

Connections:
+3.3V: U1.3 (OUT+); also elsewhere on the board
+5V: U2.3 (OUT+); also elsewhere on the board
+12V: C13.1, D7.1 (K), U1.2 (IN+), U2.2 (IN+)
/Power Supply/+12V_FUSED: D6.2 (A2), D7.2 (A), F1.2
/Power Supply/+12V_IN: F1.1, J10.1
GND: C13.2, D6.1 (A1), J10.2, U1.1 (IN-), U1.4 (OUT-), U2.1 (IN-), U2.4 (OUT-); also elsewhere on the board

Notes on the sheet:
Power Supply

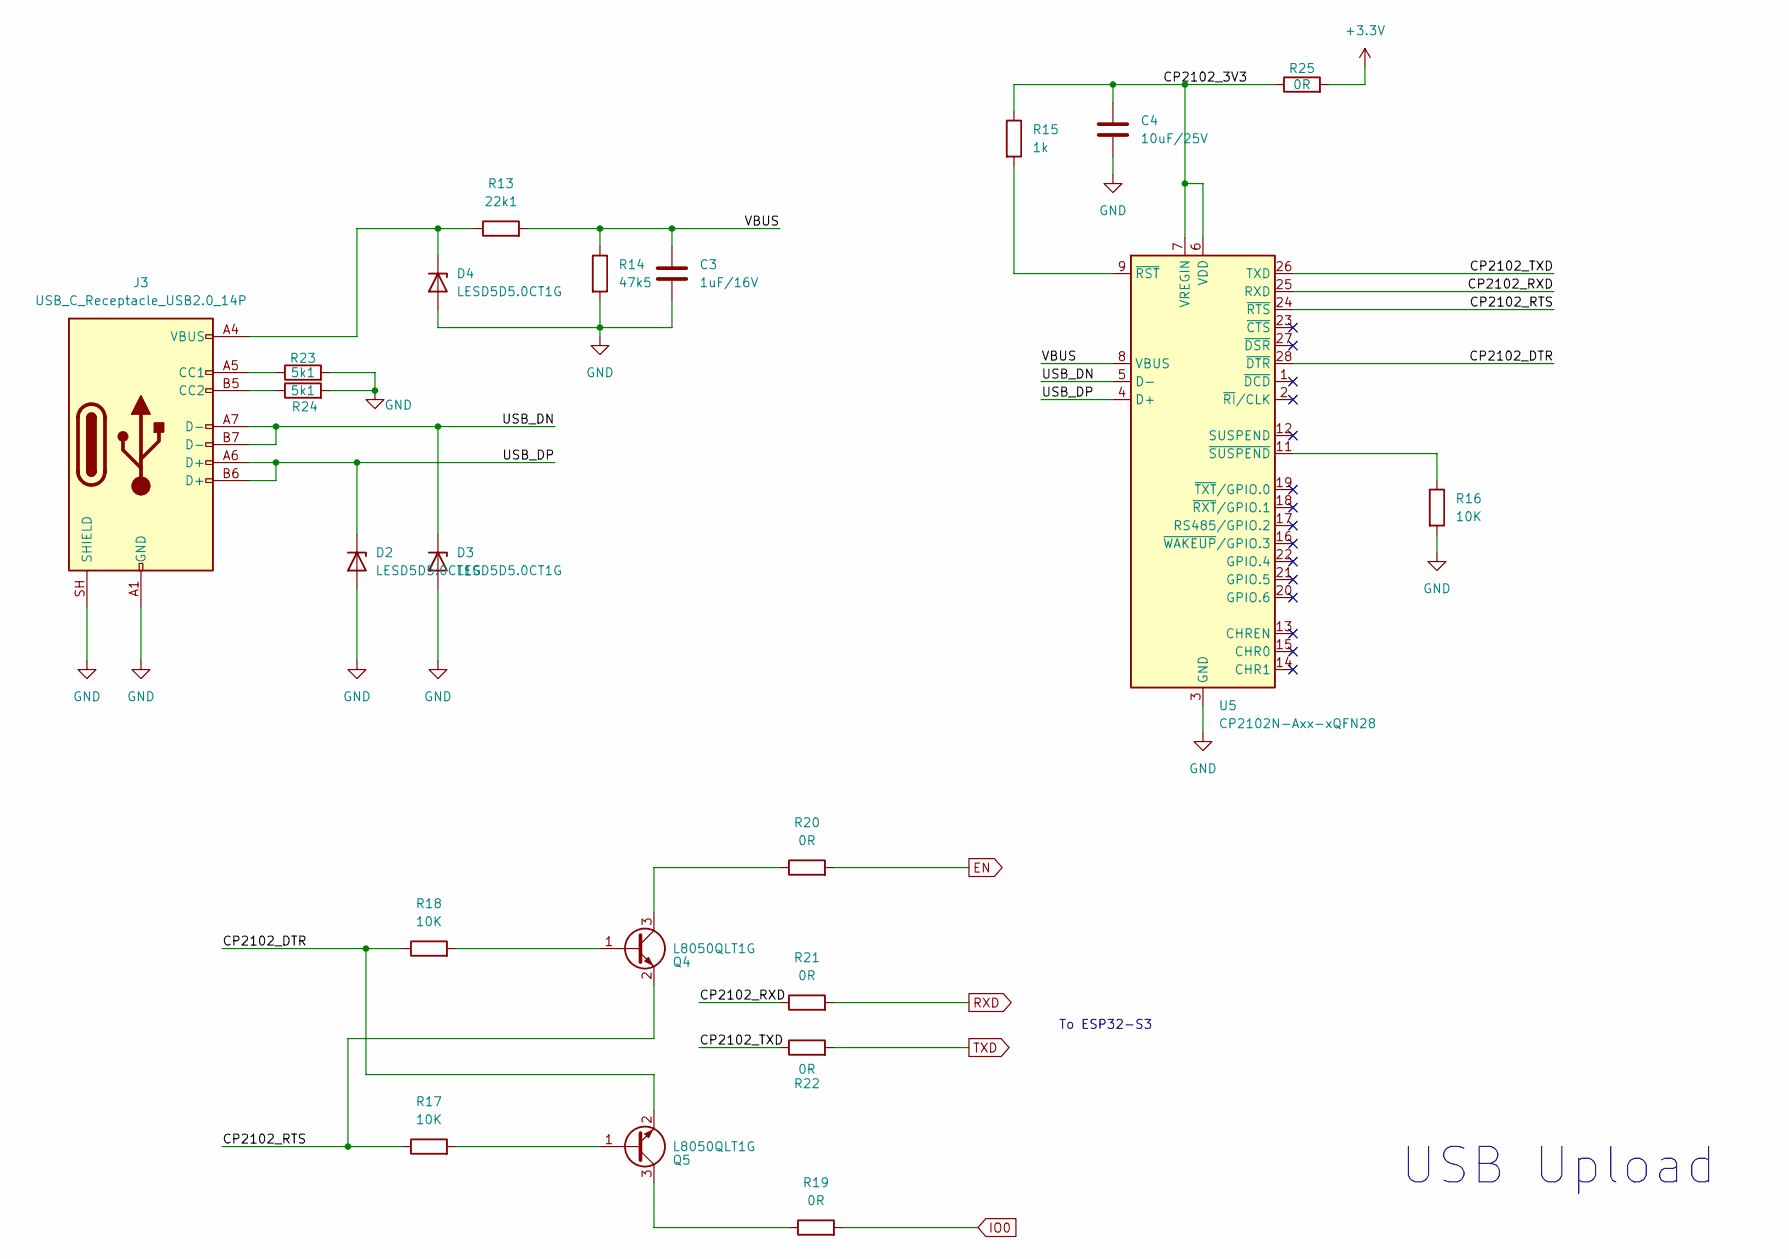
[picture p19: schematic usb2rs232.kicad_sch]

Parts:
C3: 1uF/16V; C_0603_1608Metric
C4: 10uF/25V; C_0603_1608Metric
D2, D3, D4: LESD5D5.0CT1G; D_SOD-523
J3: USB_C_Receptacle_USB2.0_14P; USB_C_Receptacle_HRO_TYPE-C-31-M-12
Q4, Q5: L8050QLT1G; SOT-23
R13: 22k1; R_0402_1005Metric
R14: 47k5; R_0402_1005Metric
R15: 1k; R_0402_1005Metric
R16, R17, R18: 10K; R_0402_1005Metric
R19, R20, R21, R22: 0R; R_0402_1005Metric
R23, R24: 5k1; R_0603_1608Metric_Pad0.98x0.95mm_HandSolder
R25: 0R; R_0402_1005Metric_Pad0.72x0.64mm_HandSolder
U5: CP2102N-Axx-xQFN28; QFN-28-1EP_5x5mm_P0.5mm_EP3.35x3.35mm

Connections:
+3.3V: R25.2; also elsewhere on the board
/USB2RS232/CP2102_3V3: C4.1, R15.1, R25.1, U5.6 (VDD), U5.7 (VREGIN)
/USB2RS232/CP2102_DTR: Q5.2 (E), R18.1, U5.28 (~DTR)
/USB2RS232/CP2102_RTS: Q4.2 (E), R17.1, U5.24 (~RTS)
/USB2RS232/CP2102_RXD: R21.1, U5.25 (RXD)
/USB2RS232/CP2102_TXD: R22.1, U5.26 (TXD)
/USB2RS232/USB_DN: D3.1 (K), J3.A7 (D-), J3.B7 (D-), U5.5 (D-)
/USB2RS232/USB_DP: D2.1 (K), J3.A6 (D+), J3.B6 (D+), U5.4 (D+)
/USB2RS232/VBUS: C3.1, R13.2, R14.1, U5.8 (VBUS)
EN: R20.2; also elsewhere on the board
GND: C3.2, C4.2, D2.2 (A), D3.2 (A), D4.2 (A), J3.A1 (GND), J3.A12 (GND), J3.B1 (GND), J3.B12 (GND), J3.SH (SHIELD), R14.2, R16.2, R23.2, R24.2, U5.3 (GND), U5.29 (GND); also elsewhere on the board
IO0: R19.2; also elsewhere on the board
unnamed: D4.1 (K), J3.A4 (VBUS), J3.A9 (VBUS), J3.B4 (VBUS), J3.B9 (VBUS), R13.1
unnamed: J3.A5 (CC1), R23.1
unnamed: J3.B5 (CC2), R24.1
unnamed: Q4.1 (B), R18.2
unnamed: Q4.3 (C), R20.1
unnamed: Q5.1 (B), R17.2
unnamed: Q5.3 (C), R19.1
unnamed: R15.2, U5.9 (~RST)
unnamed: R16.1, U5.11 (~SUSPEND)
RXD: R21.2; also elsewhere on the board
TXD: R22.2; also elsewhere on the board

Notes on the sheet:
To ESP32-S3
USB Upload

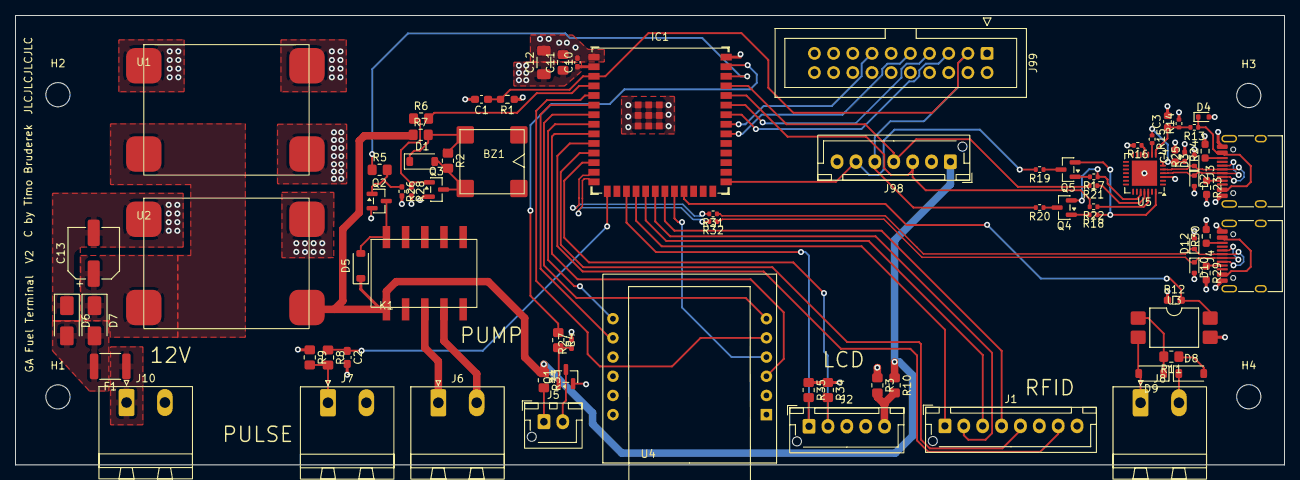
[picture p20: board GA_Fuelstation_Terminal.kicad_pcb from above]

Board: 4 copper layers, 168.0 x 59.5 mm, 83 parts (0 on the bottom side), 73 nets.
