linuxianer99/ga_fuelstation_terminal_hw/(commit log)

2023-06-21 Add 3D pics of PCB
2023-06-21 Cleanup production files
    [bom.csv, designators.csv, positions.csv]
2023-06-21 Release V1
    [bom.csv, designators.csv, positions.csv]
2023-06-21 Add schematic PDF
    [GA_Fuelstation_Terminal.kicad_pcb]
2026-10-11 add gitignore
    [GA_Fuelstation_Terminal.kicad_sch, esp32.kicad_sch, interfaces.kicad_sch, powersupply.kicad_sch]
2026-10-18 Adapted gitignore Add LAN Add USB2RS232
    [GA_Fuelstation_Terminal.kicad_pcb, GA_Fuelstation_Terminal.kicad_sch, LAN.kicad_sch, WIZ850IO--3DModel-STEP-269445.STEP, esp32.kicad_sch, interfaces.kicad_sch, usb2rs232.kicad_sch]
2026-10-18 Connect W5500 to ESP32, fix RFID SCK, add relay flyback diode
    - ESP32: add global labels LAN_CS/RST/INT/SCK/MISO/MOSI on GPIO 5/6/7/14/15/16
    (matches WIRING_OVERVIEW.md)
    - ESP32: rename SCK label to RFID_SCK so GPIO12 reaches PN532 connector J1
    - ESP32: connect WAKE_UP (optocoupler U3) to GPIO21
    - LAN: power WIZ850io from +3.3V instead of unconnected +3V3 net
    - Interfaces: add flyback diode D5 (1N4148W, LCSC C81598) across K1 coil
    - Interfaces: tie R12 pull-up to +3.3V, set value to 10k
    [LAN.kicad_sch, esp32.kicad_sch, interfaces.kicad_sch]
2026-10-18 Add input protection, fix USB-C/CP2102 supply, harden optocoupler input
    Power supply:
    - Add 12V input protection: PTC fuse F1 (1.1A/33V, C70119), TVS D6
    (SMAJ15CA, C151939), reverse polarity Schottky D7 (SS34, C8678) and
    bulk cap C13 (100uF/25V, C179802)
    USB2RS232:
    - Power CP2102N (VDD/REGIN) from +3.3V via R25 (0R)
    - Add 5k1 pull-downs R23/R24 on USB-C CC1/CC2 so C-to-C hosts supply VBUS
    ESP32 / Interfaces:
    - Add 100k gate pull-downs R26/R27/R28 on Q2/Q1/Q3 (relay, LED, buzzer
    stay off during reset/boot)
    - Buzzer flyback D1: 1N4148W SOD-123 (C81598) instead of undefined SOT-23
    - WAKE_UP input (J8/U3): series zener D8 (BZT52C6V8, C173404), reverse
    polarity diode D9 (1N4148W), R11 =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
    [GA_Fuelstation_Terminal.kicad_pcb, esp32.kicad_sch, interfaces.kicad_sch, powersupply.kicad_sch, usb2rs232.kicad_sch]
2026-10-18 - Q4/Q5: use MMBT3904 symbol (numbered pins) so SOT-23 pads map correctly
    [GA_Fuelstation_Terminal.kicad_pcb, usb2rs232.kicad_sch]
2026-10-18 Add native ESP32-S3 USB port, move buzzer driver to Interfaces sheet
    ESP32:
    - Add USB-C J4 for ESP32-S3 native USB (USB-Serial-JTAG):
    D+ -> GPIO20, D- -> GPIO19 via 0R series resistors R31/R32 (0402, C17168),
    ESD diodes D10/D12 (LESD5D5.0CT1G), CC pull-downs R29/R30 5k1,
    VBUS not connected (no-connect flag)
    - Move JTAG header J99 and decoupling C10-C12 to free space for J4
    Interfaces:
    - Move buzzer driver (Q3, R6, R28, R2, R7, D1, BZ1) from ESP32 sheet
    - Make IO_BUZZER a global label so GPIO4 still reaches R6/Q3
    - Shift optocoupler input block (J8, D8, D9, R11, R12, U3) down
    - Add PWR_FLAG on +12V after reverse polarity diode D7 (ERC clean)
    PCB: update from schematic
    E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
    [GA_Fuelstation_Terminal.kicad_pcb, esp32.kicad_sch, interfaces.kicad_sch, powersupply.kicad_sch, usb2rs232.kicad_sch]
2026-11-07 Fix pump pulse input filter timing (R9 3k3, C2 22nF)
    With R9=50k/C2=100nF the rise time constant was 6.2 ms; at max flow
    (45 l/min, 88 pulses/l = 66 Hz) the input did not reach VIH within the
    high phase. New values: tau_rise ~0.34 ms, ~1 mA contact wetting current.
    [interfaces.kicad_sch]
2026-11-07 Connect RFID_RST and RFID_IRQ to ESP32 (GPIO17/GPIO18)
    Both labels previously only reached J1, leaving the MFRC522 reset
    (NRSTPD) undefined. RFID_RST -> GPIO17 (IC1 pin 10),
    RFID_IRQ -> GPIO18 (IC1 pin 11). Clears the two ERC
    label-connected-to-only-one-pin warnings.
    [esp32.kicad_sch]
2026-11-07 Add I2C pull-ups and pump LED series resistor
    - R34/R35 4k7 pull-ups from SDA/SCL to +3.3V (no on-board pull-ups before)
    - R33 150R in the +5V feed of J5 (pump LED), limits LED current to ~20 mA
    [interfaces.kicad_sch]
2026-11-07 Mark R10 DNP: LCD display supply fixed to 3.3V
    R3 and R10 (both 0R) selected 3.3V or 5V on J2 pin 5; fitting both
    shorted the rails. Display now runs on 3.3V only (R3 fitted, R10 DNP),
    which also keeps the I2C lines at 3.3V levels.
    [interfaces.kicad_sch]
2026-11-07 U3: use SMDIP-4_W9.53mm footprint, add LCSC C63268
    SOP-4_3.8x4.1mm is the mini-flat (EL3H7/PC357) land pattern; the
    EL817S1 is a DIP-4 body (6.5 mm wide) with SMD gull-wing leads and
    would sit on the pads. Part: Everlight EL817S1(B)(TU)-F, LCSC C63268.
    [interfaces.kicad_sch]
2026-11-07 Update PCB from schematic and save KiCad project state
    [GA_Fuelstation_Terminal.kicad_pcb, esp32.kicad_sch, interfaces.kicad_sch, powersupply.kicad_sch]
2026-11-07 Switch to 4-layer JLC04161H-7628 stackup, add USB 90R diff pair class
    - Stackup per JLCPCB standard JLC04161H-7628 (1.6 mm):
    L1 35um / 7628 prepreg 0.2104 (Er 4.4) / L2 15.2um / core 1.065
    (Er 4.6) / L3 15.2um / 7628 prepreg 0.2104 / L4 35um
    - Solid GND reference plane on In1.Cu (zone, needs refill)
    - Net class USB_90R: 0.2906 mm width / 0.2032 mm gap (90 ohm
    differential L1 over L2, JLCPCB impedance calculator)
    - Name J4-side debug USB nets DBG_USBC_DP/DN so they route as a pair
    [GA_Fuelstation_Terminal.kicad_pcb, esp32.kicad_sch]
2026-11-08 Layout 99% done
    [GA_Fuelstation_Terminal.kicad_pcb, esp32.kicad_sch, powersupply.kicad_sch]
2026-11-08 Adapt USB Connector pins
    [esp32.kicad_sch]
2026-11-08 Final checks
    [GA_Fuelstation_Terminal.kicad_pcb]
2026-11-08 Added Manufacturing items
    [GA_Fuelstation_Terminal.kicad_pcb]
